davemuscle/sigma_delta_converters/tb/adc/sigma_delta_adc_tb.sv

// DaveMuscle

// Test bench for ADC

`timescale 1 ns / 1 ns

module sigma_delta_adc_tb #(
    //dut params
    parameter int OVERSAMPLE_RATE   = 256,
    parameter int CIC_STAGES        = 2,
    parameter int ADC_BITLEN        = 24,
    parameter bit USE_FIR_COMP      = 1,
    parameter int FIR_COMP_ALPHA_8  = 2,
    //tb params
    parameter int    USE_DC         = 0,
    parameter bit    OUTPUT_DIGITAL = 0,
    parameter real   DC_VALUE       = 1.67,
    parameter int    DUMP_VCD       = 0,
    parameter int    BCLK           = 12880000,
    parameter int    NUM_CYCLES     = 10,
    parameter real   VCC            = 2.5,
    parameter real   FREQUENCY      = 440.0,
    parameter real   AMPLITUDE      = 1.0,
    parameter real   OFFSET         = 1.25,
    parameter string INPUT_FILE     = "test_input.txt",  //expected raw floats representing voltage
    parameter string OUTPUT_FILE    = "test_output.txt" //same as above
);

    bit sim_done = 0;
    //testbench vcd dump and finish
    initial begin
        if(DUMP_VCD) begin
            $dumpfile("dump.vcd");
            $dumpvars;
        end
        wait(sim_done == 1);
        $finish;
    end

    // clock generator 
    localparam CLK_NS = 10**9 / (BCLK * 2);
    bit clk;
    initial begin
        forever begin
            #(CLK_NS) clk <= 0;
            #(CLK_NS) clk <= 1;
        end
    end

    localparam int NUM_SAMPLES = NUM_CYCLES * (BCLK / FREQUENCY);
    real adc_input;
    bit rst = 1;

    //generate input stimulus
    initial begin
        int fd;
        int sample_in;
        sample_in = 0;
        //proc reset
        repeat(5) @(posedge clk);
        rst <= 0;
        repeat(5) @(posedge clk);
        fd = $fopen(INPUT_FILE, "w");
        while(sample_in < NUM_SAMPLES) begin
            //generate wave
            adc_input = (!USE_DC) ? AMPLITUDE*$cos(2.0*3.14*FREQUENCY*sample_in/BCLK) + OFFSET : OFFSET;
            sample_in = sample_in + 1;
            //write to file
            $fdisplay(fd, "%f", adc_input);
            //wait for clock
            @(posedge clk);
        end
        $fclose(fd);
    end

    // lvds pin + integrator
    localparam CAP_FUDGE = 128;
    real lvds_pin_p = 0.0;
    real lvds_pin_n = 0.0;
    real increase, decrease;
    bit adc_lvds_pin, adc_fb_pin;

    always_comb begin
        //charge on capacitor is proportional to voltage stored, from Lattice
  
        //CAP_FUDGE chosen empirically, in HW this corresponds to the capacitance

        //I think you just pick a decently large value for good results here

        //In hardware I used 1 nF with 10Kohm resistor
        increase = (VCC - lvds_pin_n) / CAP_FUDGE;
        decrease = (lvds_pin_n) / CAP_FUDGE;
    end

    always_ff @(posedge clk) begin
        lvds_pin_p <= adc_input;

        //external integrator circuit
        if(adc_fb_pin) begin
            lvds_pin_n <= lvds_pin_n + increase;
        end
        else begin
            lvds_pin_n <= lvds_pin_n - decrease;
        end

        //model lvds pin
        if(lvds_pin_p > lvds_pin_n) begin
            adc_lvds_pin <= 1;
        end
        else begin
            adc_lvds_pin <= 0;
        end
    end

    bit [ADC_BITLEN-1:0] adc_output;
    bit adc_valid;

    // instantiate adc
    sigma_delta_adc #(
        .OVERSAMPLE_RATE(OVERSAMPLE_RATE),
        .CIC_STAGES(CIC_STAGES),
        .ADC_BITLEN(ADC_BITLEN),
        .USE_FIR_COMP(USE_FIR_COMP),
        .FIR_COMP_ALPHA_8(FIR_COMP_ALPHA_8)
    ) dut (
        .clk(clk),
        .rst(rst),
        .adc_lvds_pin(adc_lvds_pin),
        .adc_fb_pin(adc_fb_pin),
        .adc_output(adc_output),
        .adc_valid(adc_valid)
    );

    //write output
    initial begin: file_output
        int fd;
        int i;
        real adc_output_voltage;
        real samples_out;
        samples_out = 0;
        wait(rst == 0);
        fd = $fopen(OUTPUT_FILE, "w");
        while(sim_done == 0) begin
            //wait for valid signal
            @(posedge adc_valid) begin
                //convert to float for file io reuse
                adc_output_voltage = real'(adc_output);
                if(!OUTPUT_DIGITAL) begin
                    //convert to voltage
                    adc_output_voltage *= VCC;
                    //scale by the number of ADC bits, corresponds to:
                    //CIC_STAGES*OVERSAMPLE_RATE
                    for(i = 0; i < CIC_STAGES; i = i + 1) begin
                        adc_output_voltage = adc_output_voltage / real'(OVERSAMPLE_RATE);
                    end
                end
                samples_out = samples_out + 1;
                //write output into file
                $fdisplay(fd, "%f", adc_output_voltage);
                if(samples_out == int'(NUM_SAMPLES/OVERSAMPLE_RATE)) begin
                    sim_done = 1;
                end
            end
        end
        $fclose(fd);
    end

endmodule: sigma_delta_adc_tb
