davemuscle/sigma_delta_converters/(commit log)

2022-01-24 fixed cic filters, this is the better way compared to box avg
    [adc_tb.sv, sigma_delta_adc.sv]
2022-01-25 removed box filter, don't need to overcomplicate
2022-01-29 wrote frequency response plotter. the last sample for amplitude seems buggy, and pumping up to 192kHz also didn't work too well. need to play with it more
    [sigma_delta_adc_tb.sv]
2022-01-29 added dc blocking filter, updated harness to use floats because verilator wasn't handling signed output well
2022-01-29 cleanup signed output, only one output pin now
2022-01-30 added top level to probe design with uart, might be kind of buggy. readings out don't match simulation right now
    [sigma_delta_adc.sv, top.sv]
2022-01-30 got some decent waveforms from UART, may have fixed a bug with indexing. Played around with analog input to get low distortion measurements and take FFT of data in python script. BCLK = 50MHz, BOSR =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
    [top.sv]
2022-01-31 progress on DAD board usage and hw test, updated physical circuit to use network topology. Vref uses 1K resistors, no decoupling caps. Input network uses 10K and 6.8K resistors, and 1 nF cap. Can acc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
2022-02-01 attempt to add stdeviation, also tested signed notation in top-level. tested vref coming from io pin, seemed to maybe work better. hard to tell with general flakiness. need to put on pcb
2022-02-01 debugging gain on physical circuit and trying to resolve differences between modelsim run and verilator run. for some reason verilator returns 1x gain, modelsim < 1, and hardware 0.717
    [sigma_delta_adc.sv, sigma_delta_adc_tb.sv]
2022-02-01 added compensation FIR, need to update for other stage calculations. Vref = 1.1V (two 1K and one 1K divider), R1 = 5.6K + 10K, R2 = 10K (see lattice page), C = 1nF
2022-02-04 update model, attempting to figure out compensation filter
2022-02-04 decent compensation filter tested in hardware, need to make design modular and add other choices for alpha
2022-02-06 Stepping away from Verilator/Cocotb. Started new repo for holding fpga tools. Added that bin to path and run sim with new python flow
2022-02-08 added build flow
2022-02-10 testing gain. updated circuit
2022-02-11 playing with windows, sample size, and SNR. think we're gettin close to a good result
2022-02-11 changed dft size and removed bin forgiveness, 73 dB SNR at 440 Hz 1V amp
2022-02-11 removed Signal.py dependency, switch to scipy
2022-02-13 cleared up adc input range
2022-02-13 remove dc blocker from adc, forcing unsigned. cleanup testbench. cleanup usability with ADC_BITLEN
2022-02-14 playing around with adc and dac in hardware. updated quartus makefile to be better. trying to determine why turning on dac kills 5dB of SNR on the adc. think i'm gonna just move past it
2022-02-14 split up adc/dac sim makefiles correctly
2022-02-17 updated hardware design to use 6.25M clock for ADC/DAC going to breadboard. This really improved the noise when the DAC was on. Before I'd lose about 6 dB on the ADC side, now it's virtually none.
    [sine.py, top.sv]
2022-04-11 Added option to use dc value in adc simulation
